Mira-Spacee/waiter-robot/firmware/navigation/restaurant_map.png

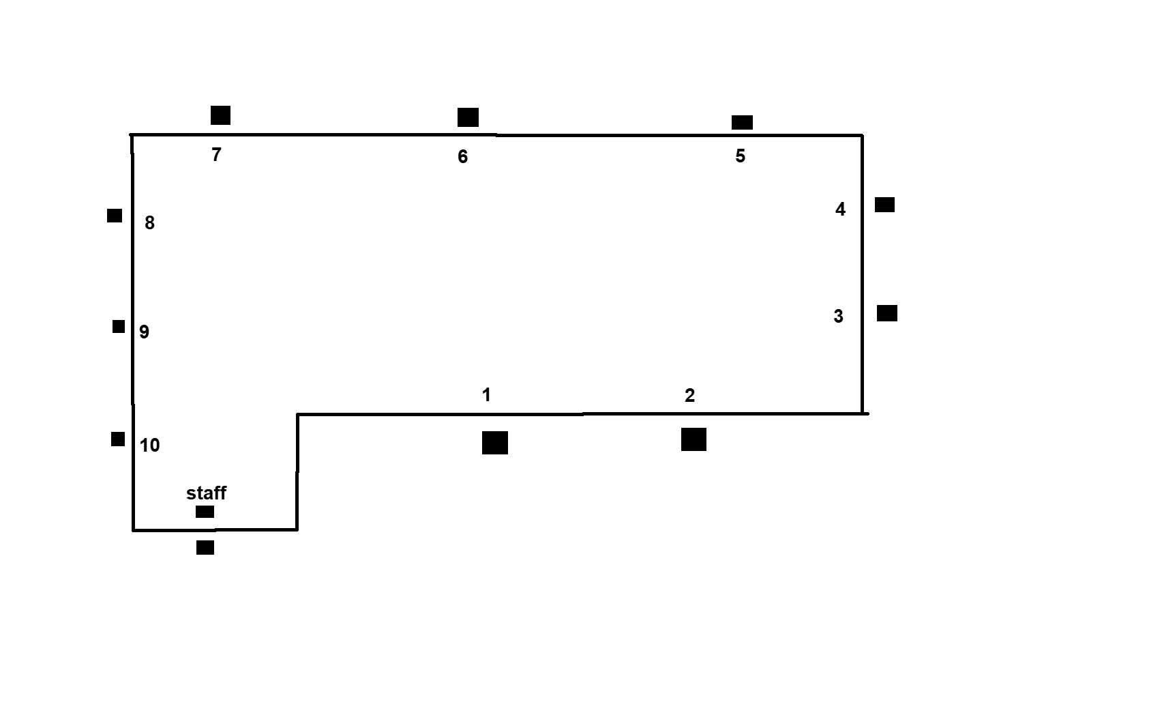
firmware/navigation/restaurant_map.png
