Mira-Spacee/waiter-robot/src/assets/burger.jpg

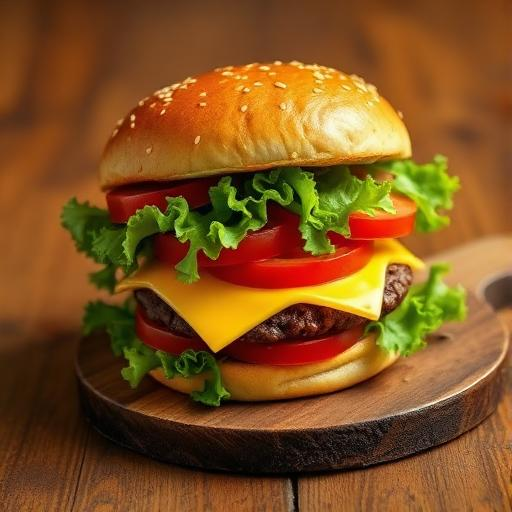
src/assets/burger.jpg
