Mira-Spacee/waiter-robot/src/assets/coffee.jpg

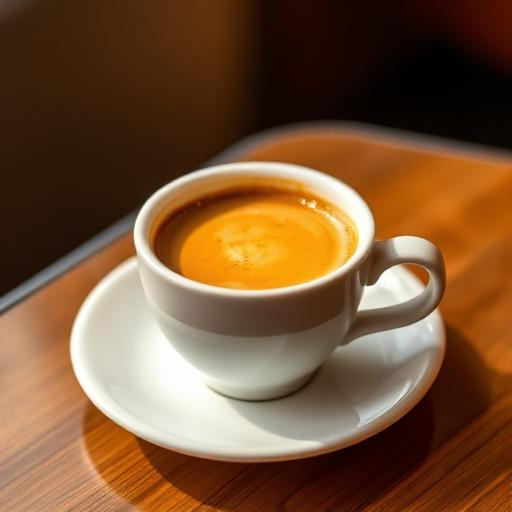
src/assets/coffee.jpg
