Mira-Spacee/waiter-robot/src/assets/juice.jpg

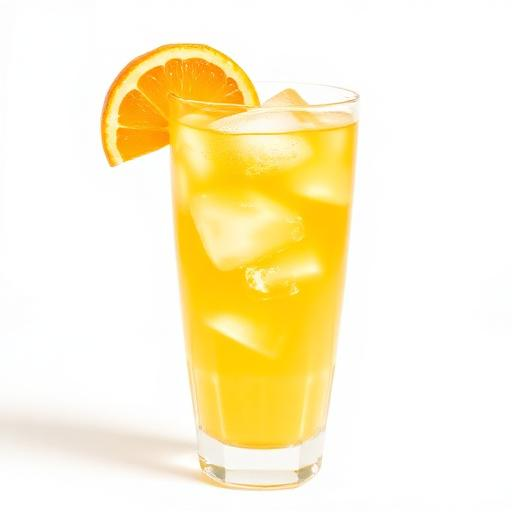
src/assets/juice.jpg
