Mira-Spacee/waiter-robot/src/assets/pasta.jpg

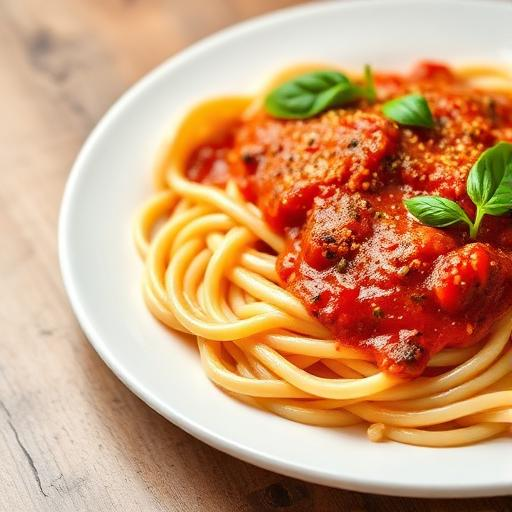
src/assets/pasta.jpg
