Mira-Spacee/waiter-robot/src/assets/salad.jpg

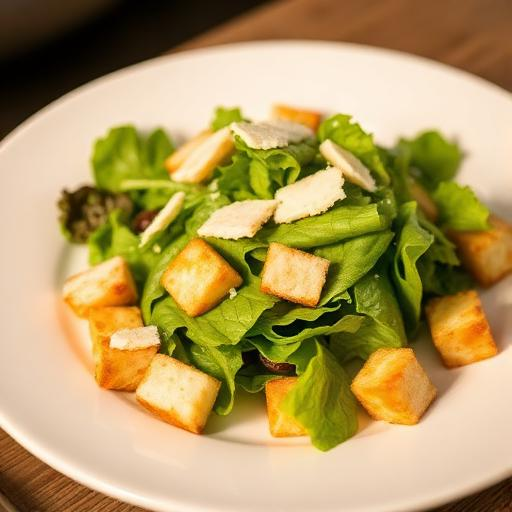
src/assets/salad.jpg
