Mira-Spacee/waiter-robot/src/assets/water.jpg

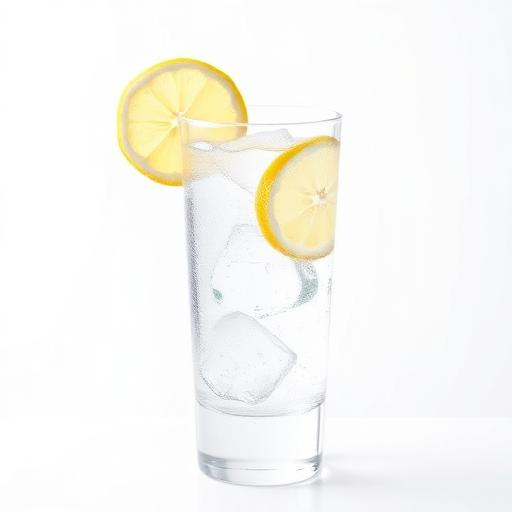
src/assets/water.jpg
