Mira-Spacee/waiter-robot/espwificamconf.ino

#include <WiFi.h>

const char* WIFI_SSID = " AVIV";
const char* WIFI_PASS = "$$$$$$$$M";

void setup() {
  Serial.begin(115200);
  WiFi.begin(WIFI_SSID, WIFI_PASS);
  Serial.println("Connecting to WiFi...");
  while (WiFi.status() != WL_CONNECTED) {
    delay(500);
    Serial.print(".");
  }
  Serial.println();
  Serial.print("Connected! IP address: ");
  Serial.println(WiFi.localIP());
}

void loop() {}
