Mira-Spacee/waiter-robot/(commit log)

2025-11-09 Initial project setup with source and docs
    Add all core source files, documentation, configuration, and assets for the restaurant ordering system. Includes frontend, backend, ESP32 integration, authentication guides, user management, and supporting scripts.
2025-12-03 Add ESP32 robot modules: MODULE1 (forward), MODULE1B (backward with back sensors), MODULE2 (180 turn), MODULE3 (table navigation)
2025-12-07 Enhance table navigation logic with backward movement support using MODULE 1B sensors. Implement directional grouping for single and multiple orders, adjusting PID parameters for smoother operation. 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
2026-06-08 Professionalize repo for public release
    - Reframe as the full AVIV autonomous waiter robot graduation project
    (hardware + firmware + web), not just the ordering web app
    - New README: hero, cost comparison, architecture, algorithms, prototype
    evolution (FV1->FV4), getting-started, authors
    - Add docs/: ARCHITECTURE, HARDWARE (full BOM + comparison), ALGORITHMS
    (PID, S-curve, table-serving), plus final-build screenshots
    - Reorganize scattered firmware into firmware/{navigation,camera-qr,
    notification,prototypes} with descriptive names + firmware/README
    - Sanitize secrets: replace hardcoded WiFi credentials and local IPs with
    placeholders across all sketches and pycam
    - Remove redundan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
    [car_prototype.ino, esp32cam_qr_server.ino, esp32cam_wifi_test.ino, imu_turn_fv3.ino, line_following_backward.ino, line_following_forward.ino, navigation_simulator.py, qr_reader.py]
2026-06-08 Hash user passwords instead of storing plaintext
    - Add server/passwordUtils.js as the single source of truth for hashing
    (SHA-256), shared by the seed and the auth/user routes so they can't drift
    - Seed default demo users (admin/admin123, staff/staff123) hashed, not plaintext
    - index_sqlite.js imports the shared hasher; login and user-creation already
    hash before compare/insert
    Verified: fresh DB seeds hashed; admin/admin123 logs in; wrong password rejected;
    stored password column is a SHA-256 hash.
