Mira-Spacee/waiter-robot/(notices)

Notices in the files:
README.md:
License: MIT
